notaroomba/cyberboard/README.md

<h1 align="center">
  <br>
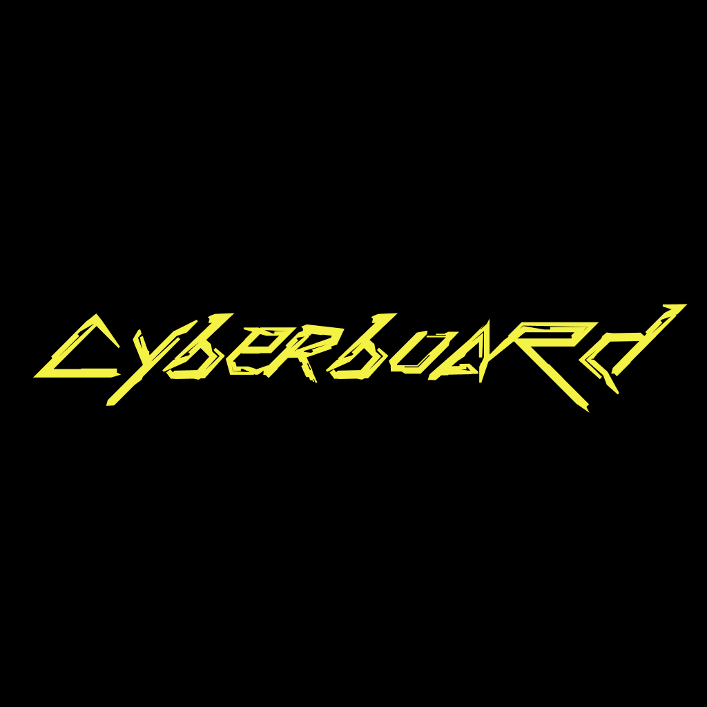
[picture p1: assets/logo.png]
Cyberboard V2
  
  <br>
  Cyberboard V2
  <br>
</h1>

<h4 align="center">
A Raspberry Pi Pico-sized STM32 development board with Bluetooth, battery support, IMU and a barometer!
</h4>

<div align="center">




</div>

<p align="center">
  <a href="#key-features">Key Features</a> •
  <a href="#pcb">PCB</a> •
  <a href="#credits">Credits</a> •
  <a href="#license">License</a>
</p>

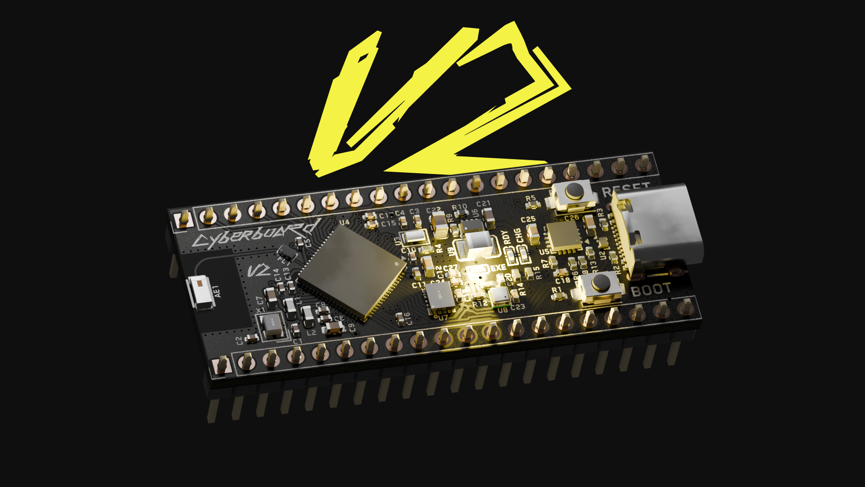
[picture p2: assets/Banner.png]
Cyberboard Banner


> **⚠️ Looking for V1?** The first version of the Cyberboard is available in the [v1 branch](https://github.com/notaroomba/cyberboard/tree/v1), but be warned: it doesn't work. V2 is a complete redesign with proper functionality.

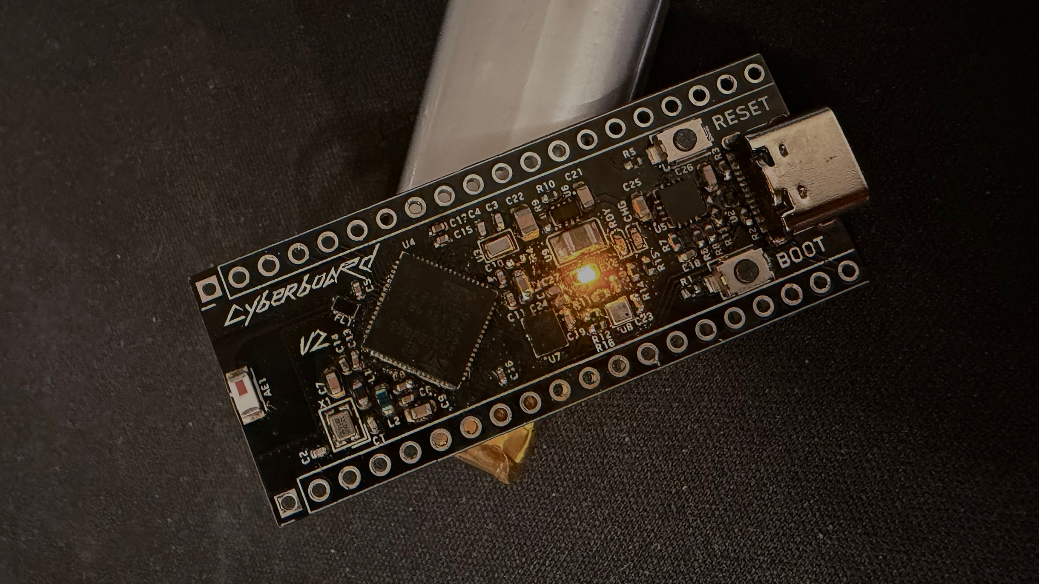
[picture p3: assets/final.png]


## Key Features

- **STM32WB55CG** microcontroller with Bluetooth support
- **Raspberry Pi Pico form factor** for compatibility
- **IMU and Barometer** - ICM-42688 (6-axis) and BMP580 pressure sensor for environmental/motion sensing
- **Battery charging** with BQ24072RGTR IC and solder pad for 1S LiPo
- **Buck-Boost converter** (TPS631000) for efficient power management
- **Multiple Status LEDs** for visual feedback
- **USB-C** connectivity
- **Ceramic Bluetooth antenna** with impedance matching
- **SWD test points** on the bottom for easy programming
- **4-layer PCB** design with optimized RF layout and routing
- **Panelized design** for cost-effective manufacturing

## PCB

Designed in KiCad with attention to RF design, power management, and sensor integration. The board features a 4-layer stackup (SIG/GND/PWR/SIG) with optimized routing for the Bluetooth antenna and sensitive analog signals.

### Schematic

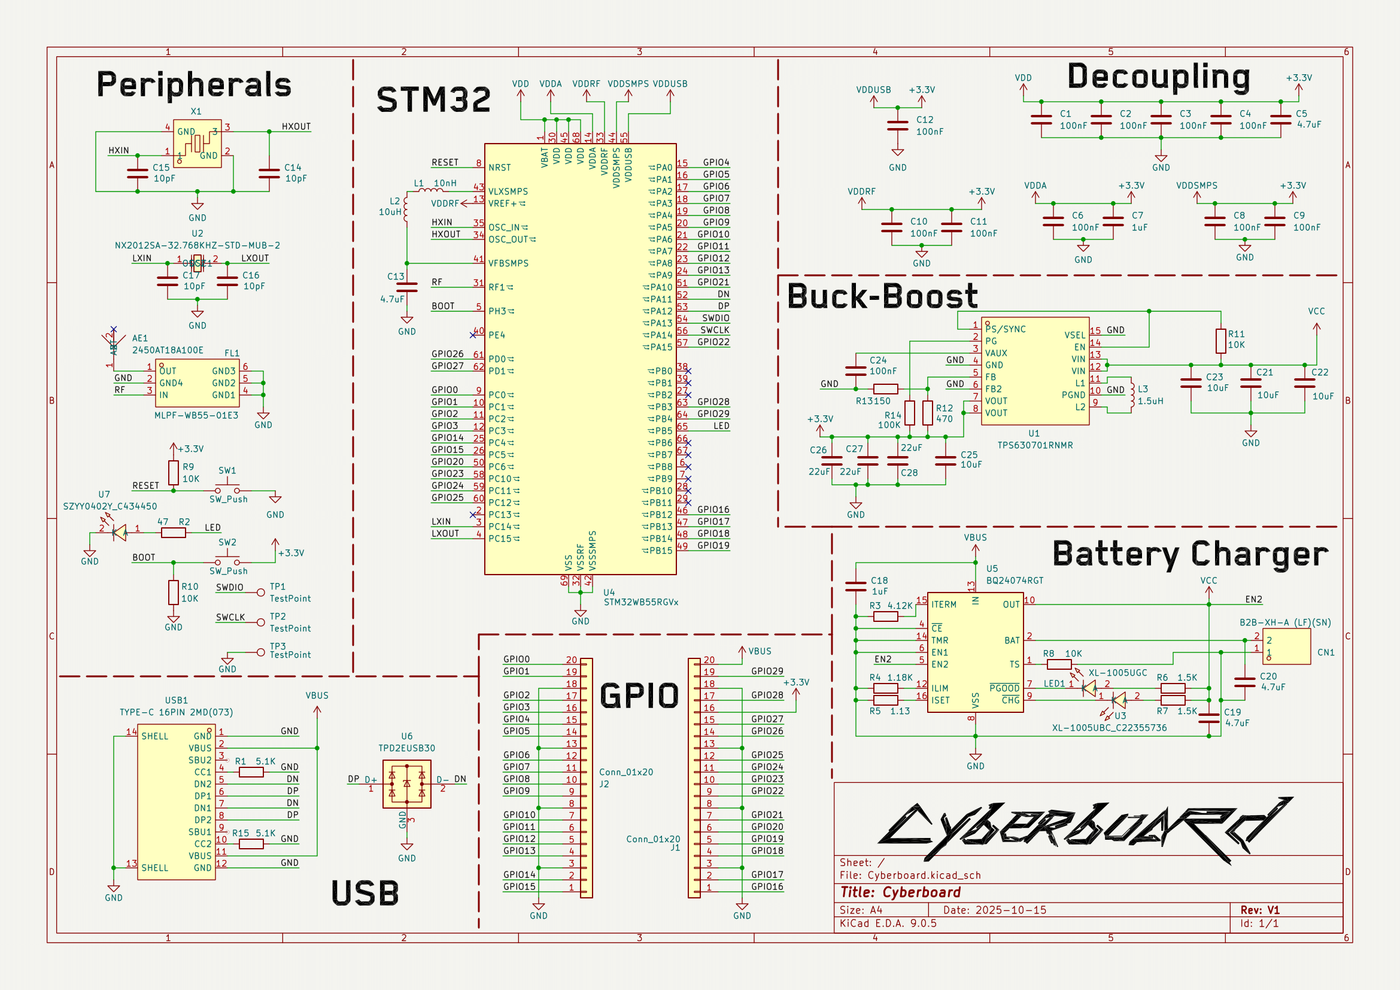
[picture p4: assets/schematic.png]
Schematic


### PCB Layers

The 4-layer stackup (SIG/GND/PWR/SIG) provides optimal signal integrity and power distribution:

**Layer 1 (Signal):**

PCB Layer 1

**Layer 2 (Ground):**

PCB Layer 2

**Layer 3 (Power):**

PCB Layer 3

**Layer 4 (Signal):**

PCB Layer 4

**Front:**

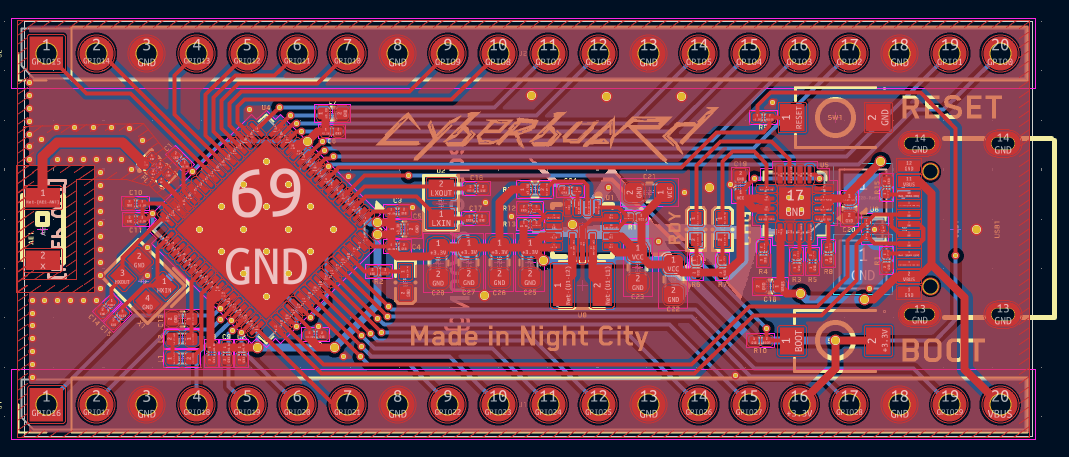
[picture p5: assets/pcb_front.png]
PCB Front


**Back:**

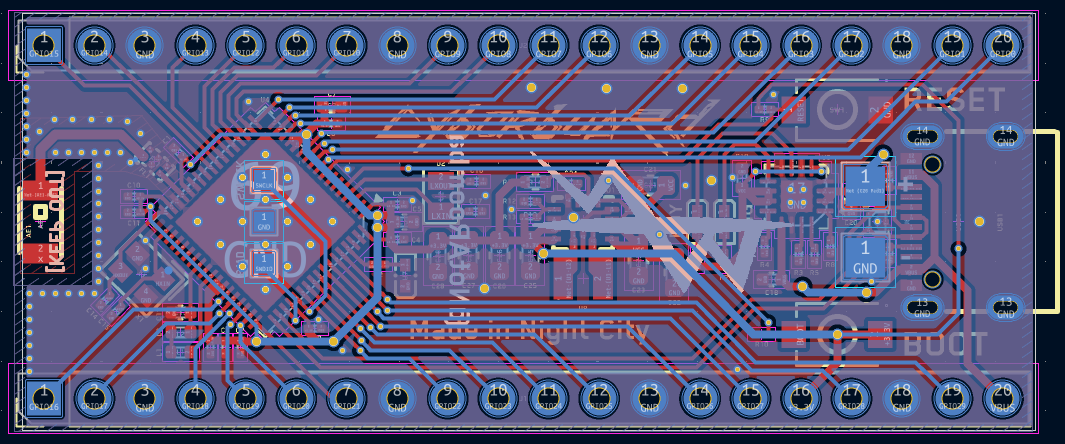
[picture p6: assets/pcb_back.png]
PCB Back


### JLCPCB Order

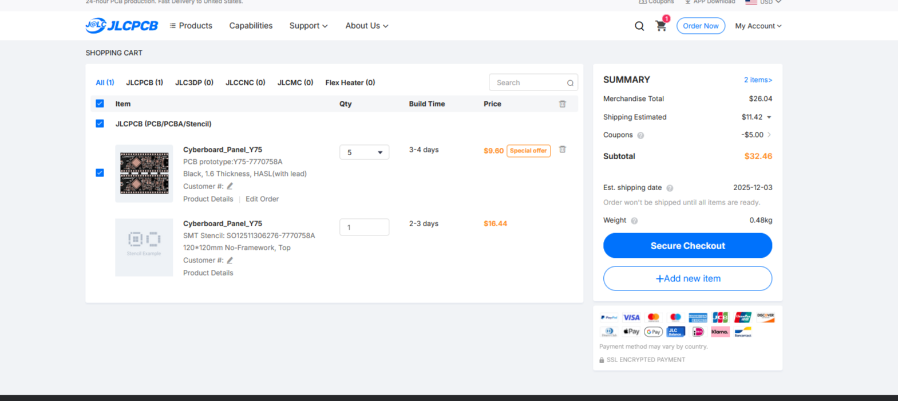
[picture p7: assets/jlcpcb.png]


## Credits

This project uses:

- [KiCad](https://www.kicad.org/)
- [Blender](https://www.blender.org/) for 3D renders
- [Hack Club Blueprint](https://blueprint.hackclub.com/projects/491)

## You may also like...

- [CyberCard](https://github.com/NotARoomba/CyberCard) – A Cyberpunk themed NFC hacker card
- [Ember](https://github.com/NotARoomba/ember) – USB-C PD Powered Hotplate
- [Trace](https://github.com/NotARoomba/trace) – An ruler for engineers
- [Athena](https://github.com/NotARoomba/athena) – A flight controlelr with a triple MCU architecture

## License

MIT

---

> [notaroomba.dev](https://notaroomba.dev) &nbsp;&middot;&nbsp;
> GitHub [@NotARoomba](https://github.com/NotARoomba) &nbsp;&middot;&nbsp;
