notaroomba/cyberboard/assets/final_rotated.png

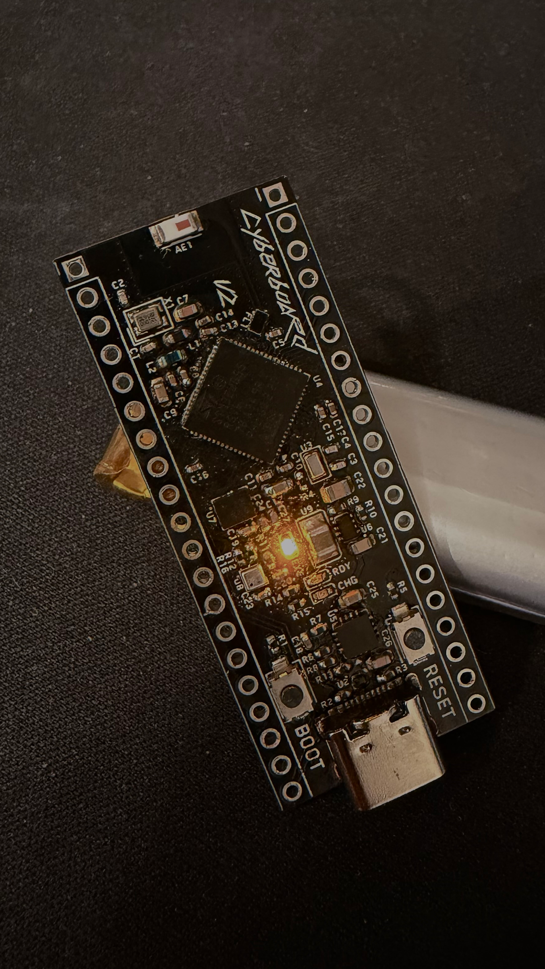
assets/final_rotated.png
