notaroomba/cyberboard/assets/jlcpcb_2.png

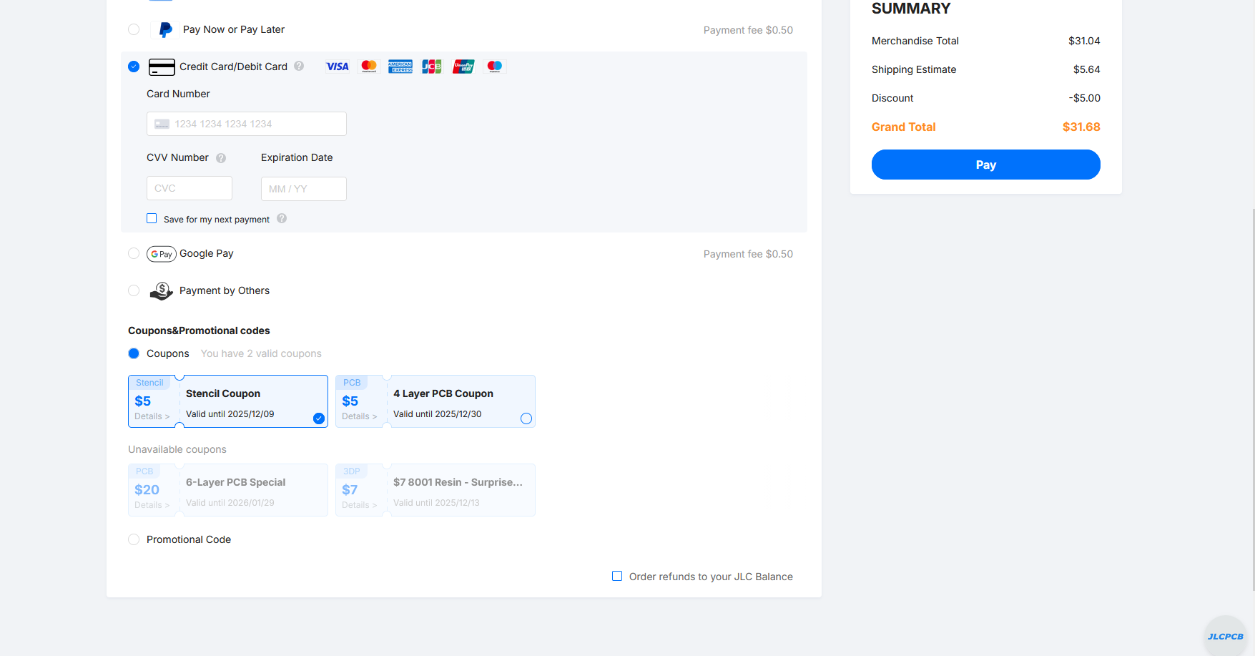
assets/jlcpcb_2.png
