notaroomba/cyberboard/assets/page.png

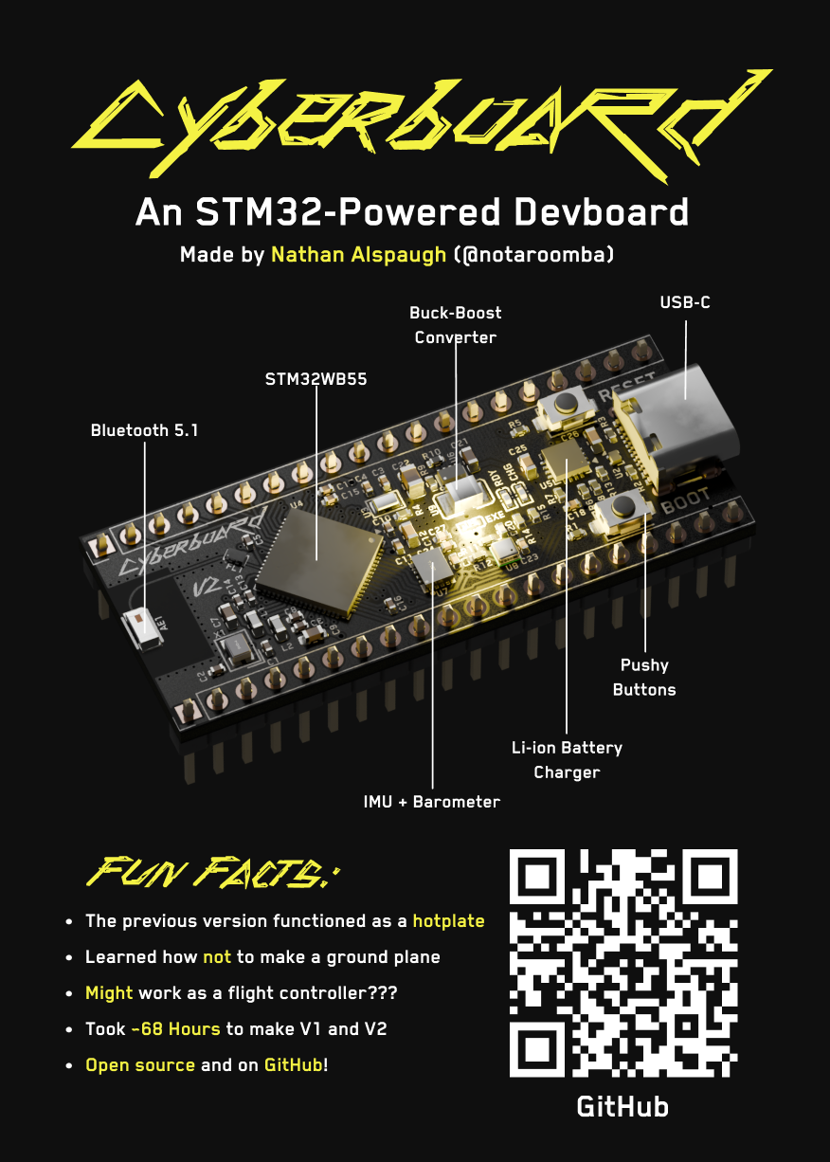
assets/page.png
