notaroomba/cyberboard/assets/Poster.png

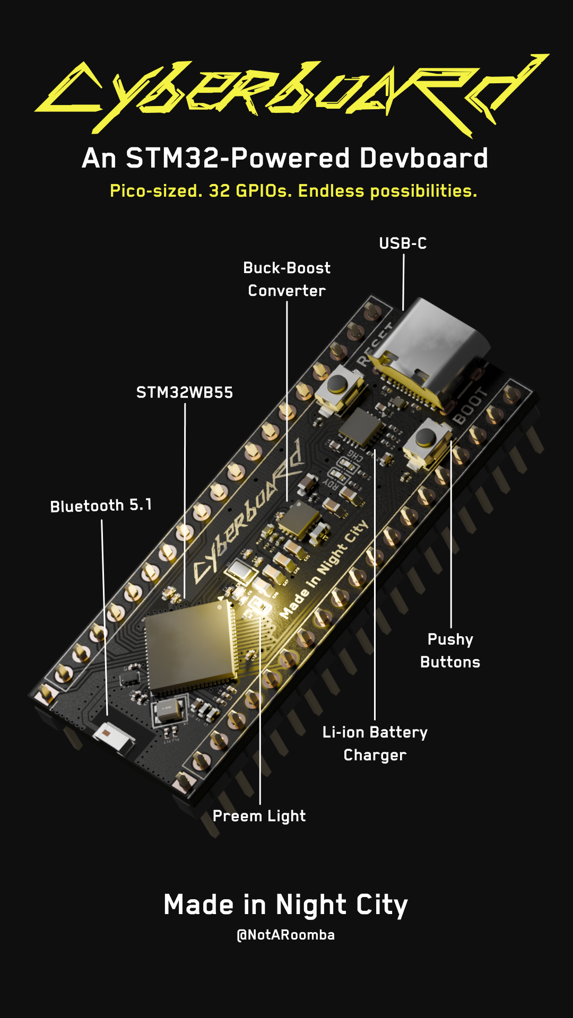
assets/Poster.png
