notaroomba/cyberboard/BOM.csv

Item | Cost | Source
PCB | 129.73 | JLCPCB
