notaroomba/cyberboard/docs/Cyberboard.step

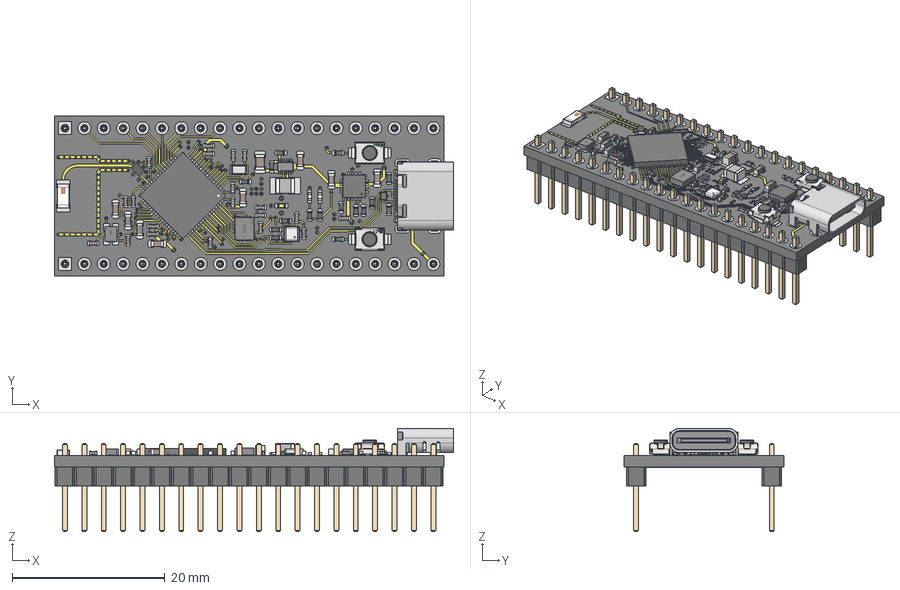
[picture p14: CAD file, 2026-03-08]
docs/Cyberboard.step
52.3 x 21.0 x 13.5 mm
SOT-583-8_L2.1-W1.2-P0.50-LS1.6-BL
C_0402_1005Metric x 20
R_0402_1005Metric x 16
C_0603_1608Metric x 6
LED0402_L1.0-W0.5-H0.2 x 2
WQFN-16-1EP_3x3mm_P0.5mm_EP1.6x1.6mm
QFN-68-1EP_8x8mm_P0.4mm_EP5.2x5.2mm
ANT-SMD_L3.2-W1.6-H1.3
L_0603_1608Metric x 2
PinHeader_1x20_P2.54mm_Vertical x 2
LGA-10_L2.0-W2.0-P0.50-TL_BMP580
CRYSTAL-SMD_L2.0-W1.2
LGA-14_L2.5-W3.0-H0.9-P0.50
L1008
C_0805_2012Metric
LED0402-FD_YELLOW
SW-SMD_L3.9-W2.9-H2.0-LS4.8 x 2
OSC-SMD_4P-L2.0-W1.6-H0.8
Texas_DRT-3
USB-C-SMD_TYPE-C-6PIN-2MD-073
FILTER-SMD_6P-L1.6-W1.0-P0.50-BL
Cyberboard_copper
Cyberboard_pad
Cyberboard_via
Cyberboard_PCB
