notaroomba/cyberboard/(list of files, cad)

Other CAD files:
blender/Cyberboard.blend
