notaroomba/cyberboard/JOURNAL.md

<!--
  Exported from Hack Club Blueprint on 2026-09-27.
  Source: https://blueprint.hackclub.com/projects/2195
  V1 source: https://blueprint.hackclub.com/projects/491
-->

# Cyberboard V1

## 10/13/2025 - Chip Selection and Schematic Start  

_Time spent: 5.0h_  

First I'm starting to define the functionality of the board. I want it to be the size of a Raspberry Pi Pico, and I want it to have Bluetooth support as well as headers for the STM32. I also want a JST connector to charge a 1S LiPo Battery for portability so I need a battery charging IC.

Chip Selection:

- STM32WB55CG
- TPS630701RNMR (Buck-Boost Converter)
- BQ24074 (Battery Charger)

Extras:

- SPI LEDs
- USB LEDs
- Battery JST Connector
- USB-C
- Ceramic Bluetooth Antenna



## 10/15/2025 1 AM - Finish Schematic and PCB Routing  

_Time spent: 9.0h_  

I started looking through all of the datasheets of all of the parts that I used to get the reference designs for each of the chips and then started wiring up each component.

I then ended up with this:


I still have to wire out the headers but I'm planning on doing that last after I have all the passive components in place.



## 10/15/2025 11 PM - Layout and Finish Board  

_Time spent: 12.0h_  

I decided to finish the layout and during, I wanted to add an LED and also the debugging pins as test points on the bottom of the board.



I then started routing all of the GPIO's first, then the clocks and then the power stuff. I used .2mm traces for everything that wasn't power and .4mm traces for power.



I also had to impedance match the antenna so basing it off this datasheet:


I then added the traces and also put stitching vias on the side. I also added the keepout zone and made sure that the ground plane on either side had the right clearance.



After that I finished adding the ground pours and ran DRC to fix the remaining errors and finally got this.



After finishing the board I decided to do some renders in Blender and here are the photos.





## 10/16/2025 - Resized Keep-out zone  

_Time spent: 0.8h_  

I decided to resize the keep-out zone after some advice from my informatics teacher and looking online at the datasheet. It originally says to have a 6.5mm space but I don't have that much space horizontally as I do vertically so the most I could do was 4.3mm.

Before: 

WhatsApp Image 2025-10-15 at 16.54.22_8be48b74.jpg

After:



## 10/17/2025 - Rerouted PCB on single side to save costs  

_Time spent: 6.0h_  



I had to reroute everything as the board was too expensive for double sided PCBA. So I decided to reduce the sizes down to 0201 for some components like the decoupling capacitors to try and save space and it worked. I then had enough space to move the battery charging IC to the other layer and I had to remove the JST connector and replaced it with 2 exposed pads on the bottom.




  

## 11/15/2025 - Tried fixing the PCB  

_Time spent: 14.0h_  

After receiving my board I rushed to plug it in but then it wouldn't connect and turned super hot. Later that day I sent it in the KiCad discord and turns out that everything was supposedly fine. A few days later after letting my intrusive thoughts win and letting the board heat up, I revised the schematics again and noticed there's a few errors. First of all I believe that I messed up the ground plane and literally encased the STM32 in 3V3 ring:



Then there's the other error of me not using the right decoupling capacitor values which should be 4.7uF.



Finally another error that completely hinders me from fixing the board is that those components are 0201 and are small and also expensive to manufacture (sorry I've learned my lesson)

WhatsApp Image 2025-11-15 at 00.44.59_852fff6f

I spent the entire day trying to learn how to solder 0201 as I was trying to see if I could connect a capacitor that I took from an old wifi router to the board. I tried doing this by soldering a thin copper wire (taken from a jumper cable) to the end of a capacitor and then that capacitor to ground:

WhatsApp Image 2025-11-15 at 00.44.59_0f044e43

WhatsApp Image 2025-11-15 at 00.44.59_217dc7c0

Although my soldering iron kept burning the flux and I had to use nail polish remover to try and clean it because I don't have isopropyl alcohol.

WhatsApp Image 2025-11-15 at 01.02.20_5e53268a

After talking with @Kai Pereira, I realized that I had a lot to improve in terms of cost and component selection and that's my goal for V2, to make it as cheap as possible < 50 USD, and maybe include more features.

All this I plan to do after I finish my heatplate as I want to be able to solder everything by hand.

## 12/1/2025 - Banner Image  

_Time spent: 0.1h_  

Finally fixed the bug so heres a temp journal to add in the banner so that it looks cool on the blueprint website aaaaaaaaaaaaaaaaaaaaaaaaaaaaaaaaaaaaaaaaaaaaa

Banner

# Cyberboard V2

## 11/28/2025 - Fixed Schematic and Add Sensors  

_Time spent: 6.0h_  

So after the first iteration of the Cyberboard, there were a lot of issues, mainly me being stupid and not using the right values but also in the design of the PCB (not using 4 layers) so in this version I am going to fix that and upgrade it by adding an IMU/Barometer to make it the ultimate devboard for small projects!

Ah and I also plan on hand soldering it / reflow it using my custom hotplate (lol making tools to make tools) so it will be way cheaper and make up for my past mistakes.

I will be adding on the ICM-42688 and BMP580 and also I was thinking about reducing the size of the buck-boost converter as it was one of the biggest contributors to price/complexity on the board. So like any good engineer, I went on LCSC and searched for the most used DC DC converter to implement and found TPS631000 and it's perfect looking at the application implementation:



I think with this I can rewire the board completely and add in more functionality. So I thought about what other cool functionality and I decided on adding in a current sensor for the battery

 

I also found a cheaper battery charging IC: BQ24072RGTR instead of the BQ24074RGT

The only thing they have differently is one pin that instead of ITERM it's TD:



AND IT'S WAY CHEAPER AND COSTS ONLY 0.8 USD INSTEAD OF 3 USD

AND IT's LITERALLY A DROP IN REPLACEMENT FOR THAT CHIP:



I just had to change the value for TD to a more standarized value but it should work the same as a pull down resistor:


Reading through the datasheet I also saw that the example application was using a custom timer and to reduce cost even more I decided to use the default timer as that will suffice.



After I got the battery fixed I went on and fixed the decoupling capacitors for the STM32:



After that I imported the new buck converter and looked at the datasheet:



I had to import this inductor `DFE252012P-1R0M=P2` as it was specified in the datasheet:



After setting up the rest of the pins, I came up with this: 



Now it's time to set up the sensors that I'll be using (ICM-42688-PC and BMP580):



Thankfully I have enough pins free on my devboard, and you can't say that a devboard is a devboard if you aren't using all of the pins lol.



but before deciding on which communication interface I'm going to use, I'll have to edit the pins on STM32CubeMX:



I originally had some EVENTOUT pins that labeled which pins weren't going to be used but this time, I am going to try and use all of them. In total I have 11 pins free to play around with, I plan on using LED's with the extra pins to at least have 3 status ones.  

## 11/30/2025 12:04 AM - PCB Layout and Routing  

_Time spent: 5.0h_  

I started the layout of the PCB and noticed a few errors in my schematic and fixed them (I2C lines strike again) and then had something like this:



I found out that I can compact the board alot and make room for the antenna as I plan to use the bottom layer mainly for the GPIO's as the top layer is kind of busy with all of the passive components.

I organized it a bit more and got this layout, but I wasn't satisfied with the way that there was a squareish hole off center so I redid it again


(before)


(after)

And after that I didn't liked how it looked so I went back to the original and planned on putting a V2 in the squareish hole.

I then started routing up the design and also making minor changes here and there to not cover some silkscreen, I also enjoyed routing this section as I find that it looks cool the stripe effect:



## 11/30/2025 12:27 AM - Pin Selection (BEFORE PREVIOUS JOURNAL)  

_Time spent: 4.0h_  

I started selecting the pins on STM3CubeMX and wanted to use I2C for the BMP580 and then SPI for the IMU. Another design requirement is that I wanted it as far away from the Bluetooth antenna as possible, which is why I decided on this pinout:



I might interchange the CS and interrupt pins as to better route it later but that's a good starting point. I then finished wiring the ICM:



AND I REMEMBERED TO ADD PULL UP RESISTORS TO THE I2C LINES



then I had to organize the schematic a bit as there wasn't any space for the new sensors lol



I then edited the footprints and made sure that all of them were at least 0402 (ptsd soldering 0201).

I forgot that I had this draft saved on one laptop so when I used another I pushed a journal from there and I forgot about these changes so aja, this journal comes before `PCB Layout and Routing`  

## 11/30/2025 2 AM - Finished Routing and Antenna  

_Time spent: 2.0h_  

I spent a bit of time finishing up the routing and also making sure that everything looks neat including the silkscreen:



I somehow did it and managed to fit an IMU and Barometer in such a tiny 1 SIDED BOARD

I had fun routing the antenna as I had a crisis and thought I had my antenna for Ember wrong but I just recalculated the impedance badly



It's a 4 layer board so SIG/GND/PWR/SIG and I had some stitching vias for 3v3:



Aside from that I just finished routing and tmrw I'll start work on the renders and also getting feedback from the KiCad Discord.

## 11/30/2025 1 PM - Blender Render, Panelization, and LCSC  

_Time spent: 4.0h_  

After fixing some pins that were out of order due to routing, I started rendering the PCB in Blender based on the last file. 

Banner



It looks a bit drab so I am going to add in more lights like in Trace and see if that helps out a bit.

Meanwhile, I decided to panelize the PCB because in V1, there was a lot of extra space that I could use to make more copies and not have to pay extra.



After that I also exported the BOM and went to LCSC to check out how much it cost and it was surprisingly cheap at (taking advantage of the MOQ for most).

I also had to specify the stackup (which I kinda forgot to do for Ember but I sent an email requesting to change it). This also meant that I had to change the width of the traces and also the width of the board.

## 3/7/2026 - IT WORKS!!!  

_Time spent: 39.0h_  

ookay so its been a while since I've worked on this since getting a gap year so I finally finished it and it works!

basically I had all of the components and saw the stencil and it was a bit hard to get right



and then decided to try and hotplate it with Ember in a hotel lobby (actually)



and it worked kinda! although at first it turned on but didn't connect to my laptop so I was wondering why that was, but I hadn't had time to debug it until I stopped moving around.



it was then until I finally got to HQ and found a lovely soldering station but I kinda wanted to make more PCB's to try and test them so I did a thing in my room and reflowed another one:



but it faced the same problem that the usb wouldnt enumerate so I figured that it was a problem with the STM32

I wouldn't give up tho so I went to HQ and found that they had a wonderful hot air machine and hot plate so I tried reflowing the STM32 again to try and fix it



but after a few tries of soldering it on and off it still hadn't worked but it was then that it started connecting to my PC but when I tried making a test program for the yellow light it wouldn't turn it on, and I tested with a multimeter and it should have worked but then i took a look at the side and apparently the stm wasn't totally connected so I had to retry again until it worked



now I could connect to it but I still had a few problems with the barometer so I tried to resolder it and actually had to cut a trace because it wasn't supposed to be connected to ground (CSB)





and that worked because initially it wasnt detecting any chips on the i2c line that the bmp580 was on so yea...

after I got that working it was time for the IMU and heres where it got crazy, so I first got some drivers for it and tried to connect to the IMU and get its WHOAMI register but it kept giving me 0x00 (nothing) so that was kinda suspicious so then I reflowed it varios times until I noticed that it might be a different imu because the chip symbols were different and IT WAS!

looking through the LCSC part number on the package it was different from the one that I had originally wanted

 



in any case I still fixed and started up a demo that showcased all of the features of the board!
