notaroomba/cyberboard/hardware/Cyberboard.kicad_pcb

## KiCad design hardware/Cyberboard.kicad_pcb (2026-10-11)

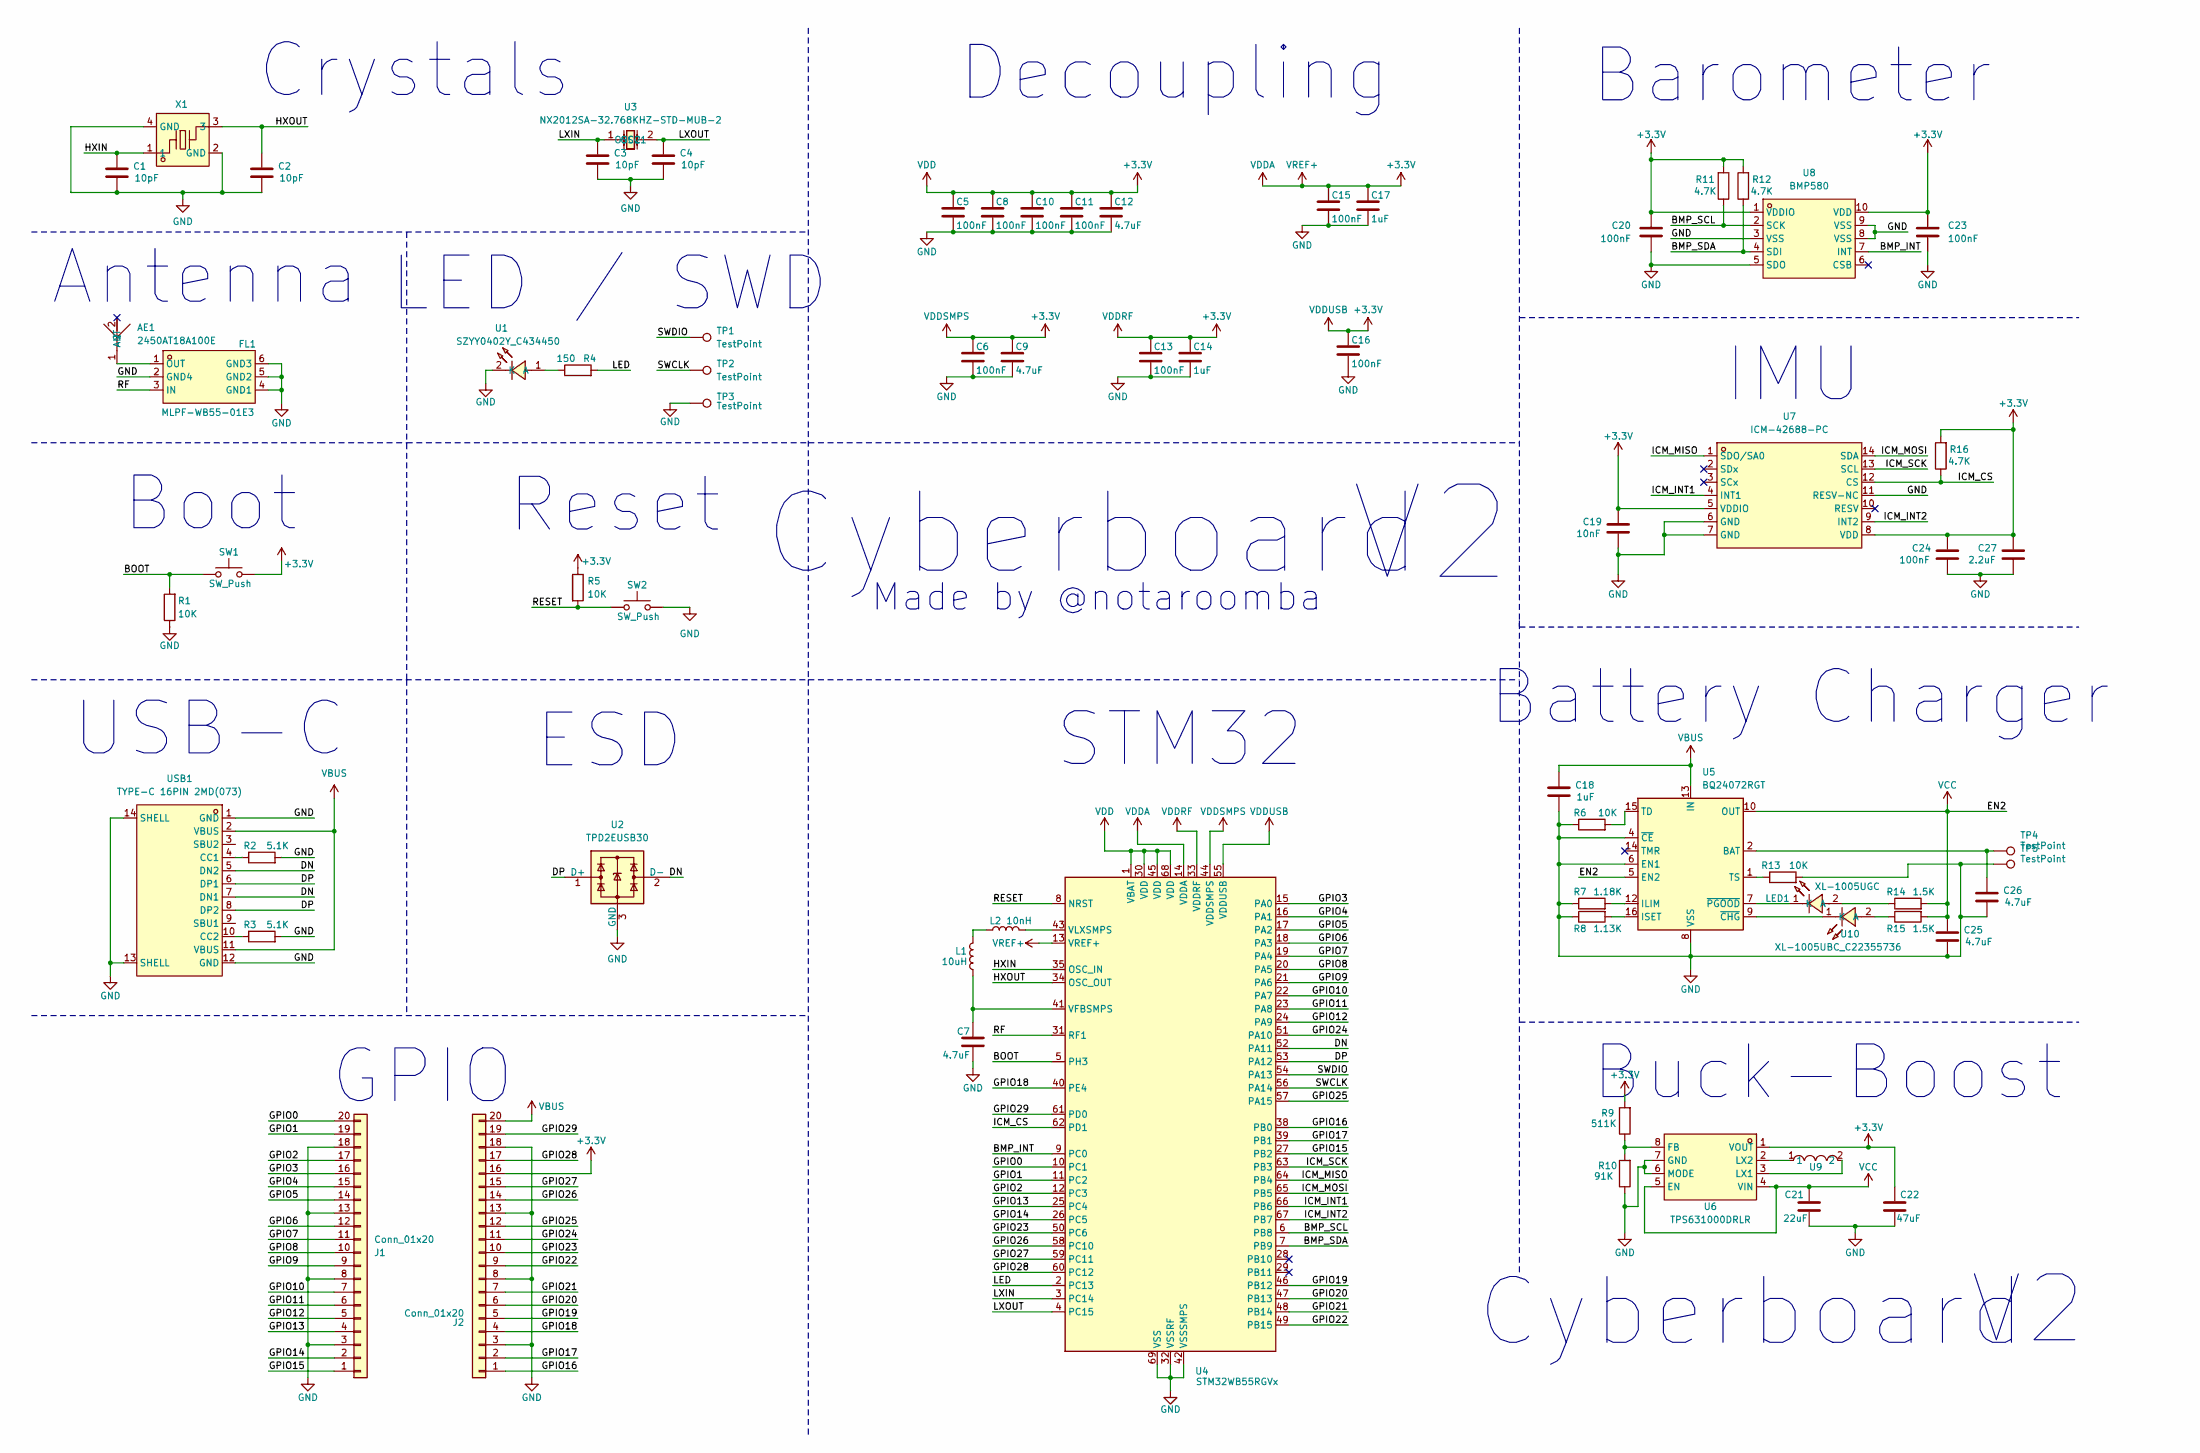
[picture p15: schematic Cyberboard.kicad_sch]

Parts:
AE1: 2450AT18A100E; ANT-SMD_L3.2-W1.6; LCSC Part C89334
C1, C2, C3, C4: 10pF; C_0402_1005Metric
C5, C6, C8, C10, C11, C13, C15, C16, C20, C23, C24: 100nF; C_0402_1005Metric
C7, C9, C12, C25, C26: 4.7uF; C_0603_1608Metric
C14, C17, C18: 1uF; C_0402_1005Metric
C19: 10nF; C_0402_1005Metric
C21: 22uF; C_0603_1608Metric; LCSC C361061
C22: 47uF; C_0805_2012Metric; LCSC C471380
C27: 2.2uF; C_0402_1005Metric
FL1: MLPF-WB55-01E3; FILTER-SMD_6P-L1.6-W1.0-P0.50-BL; LCSC Part C2651048
J1, J2: Conn_01x20; PinHeader_1x20_P2.54mm_Vertical; LCSC C42431804
L1: 10uH; L_0603_1608Metric
L2: 10nH; L_0603_1608Metric
LED1: XL-1005UGC; LED0402-RD_GREEN; LCSC Part C965793
R1, R5, R6, R13: 10K; R_0402_1005Metric
R2, R3: 5.1K; R_0402_1005Metric
R4: 150; R_0402_1005Metric; LCSC C25082
R7: 1.18K; R_0402_1005Metric
R8: 1.13K; R_0402_1005Metric
R9: 511K; R_0402_1005Metric
R10: 91K; R_0402_1005Metric
R11, R12, R16: 4.7K; R_0402_1005Metric
R14, R15: 1.5K; R_0402_1005Metric
SW1, SW2: SW_Push; SW-SMD_L3.9-W3.0-P4.45; LCSC C720477
TP1, TP2, TP3: TestPoint; TestPoint_Pad_1.0x1.0mm
TP4, TP5: TestPoint; TestPoint_Pad_2.0x2.0mm
U1: SZYY0402Y_C434450; LED0402-FD_YELLOW; LCSC Part C434450
U2: TPD2EUSB30; Texas_DRT-3
U3: NX2012SA-32.768KHZ-STD-MUB-2; CRYSTAL-SMD_L2.0-W1.2; LCSC Part C891748
U4: STM32WB55RGVx; QFN-68-1EP_8x8mm_P0.4mm_EP6.4x6.4mm; LCSC C401505
U5: BQ24072RGT; VQFN-16-1EP_3x3mm_P0.5mm_EP1.6x1.6mm; LCSC C140288
U6: TPS631000DRLR; SOT-583-8_L2.1-W1.2-P0.50-LS1.6-BL; LCSC Part C5219190
U7: ICM-42688-PC; LGA-14_L3.0-W2.5-P0.50-TL; LCSC Part C48586483
U8: BMP580; LGA-10_L2.0-W2.0-P0.50-TL_BMP580; LCSC Part C22391138
U9: DFE252012P-1R0M=P2; L1008; LCSC Part C882955
U10: XL-1005UBC_C22355736; LED0402-RD; LCSC Part C22355736
USB1: TYPE-C 16PIN 2MD(073); USB-C-SMD_TYPE-C-6PIN-2MD-073; LCSC Part C2765186
X1: NX2016SA-32MHZ-STD-CZS-5; OSC-SMD_4P-L2.0-W1.6-BL; LCSC Part C843260

Connections:
+3.3V: C5.1, C6.1, C8.1, C9.1, C10.1, C11.1, C12.1, C13.1, C14.1, C15.1, C16.1, C17.1, C19.1, C20.1, C22.1, C23.1, C24.1, C27.1, J2.16, R5.1, R9.2, R11.2, R12.2, R16.2, SW1.2, U4.1 (VBAT), U4.13 (VREF+), U4.14 (VDDA), U4.30 (VDD), U4.33 (VDDRF), U4.44 (VDDSMPS), U4.45 (VDD), U4.55 (VDDUSB), U4.68 (VDD), U6.1 (VOUT), U7.5 (VDDIO), U7.8 (VDD), U8.1 (VDDIO), U8.10 (VDD)
/BMP_INT: U4.9 (PC0), U8.7 (INT)
/BMP_SCL: R11.1, U4.6 (PB8), U8.2 (SCK)
/BMP_SDA: R12.1, U4.7 (PB9), U8.4 (SDI)
/BOOT: R1.2, SW1.1, U4.5 (PH3)
/DN: U2.2 (D-), U4.52 (PA11), USB1.5 (DN2), USB1.7 (DN1)
/DP: U2.1 (D+), U4.53 (PA12), USB1.6 (DP1), USB1.8 (DP2)
/GPIO0: J1.20, U4.10 (PC1)
/GPIO1: J1.19, U4.11 (PC2)
/GPIO2: J1.17, U4.12 (PC3)
/GPIO3: J1.16, U4.15 (PA0)
/GPIO4: J1.15, U4.16 (PA1)
/GPIO5: J1.14, U4.17 (PA2)
/GPIO6: J1.12, U4.18 (PA3)
/GPIO7: J1.11, U4.19 (PA4)
/GPIO8: J1.10, U4.20 (PA5)
/GPIO9: J1.9, U4.21 (PA6)
/GPIO10: J1.7, U4.22 (PA7)
/GPIO11: J1.6, U4.23 (PA8)
/GPIO12: J1.5, U4.24 (PA9)
/GPIO13: J1.4, U4.25 (PC4)
/GPIO14: J1.2, U4.26 (PC5)
/GPIO15: J1.1, U4.27 (PB2)
/GPIO16: J2.1, U4.38 (PB0)
/GPIO17: J2.2, U4.39 (PB1)
/GPIO18: J2.4, U4.40 (PE4)
/GPIO19: J2.5, U4.46 (PB12)
/GPIO20: J2.6, U4.47 (PB13)
/GPIO21: J2.7, U4.48 (PB14)
/GPIO22: J2.9, U4.49 (PB15)
/GPIO23: J2.10, U4.50 (PC6)
/GPIO24: J2.11, U4.51 (PA10)
/GPIO25: J2.12, U4.57 (PA15)
/GPIO26: J2.14, U4.58 (PC10)
/GPIO27: J2.15, U4.59 (PC11)
/GPIO28: J2.17, U4.60 (PC12)
/GPIO29: J2.19, U4.61 (PD0)
/HXIN: C1.1, U4.35 (OSC_IN), X1.1
/HXOUT: C2.1, U4.34 (OSC_OUT), X1.3
/ICM_CS: R16.1, U4.62 (PD1), U7.12 (CS)
/ICM_INT1: U4.66 (PB6), U7.4 (INT1)
/ICM_INT2: U4.67 (PB7), U7.9 (INT2)
/ICM_MISO: U4.64 (PB4), U7.1 (SDO/SA0)
/ICM_MOSI: U4.65 (PB5), U7.14 (SDA)
/ICM_SCK: U4.63 (PB3), U7.13 (SCL)
/LED: R4.2, U4.2 (PC13)
/LXIN: C3.1, U3.1 (OSC1), U4.3 (PC14)
/LXOUT: C4.1, U3.2 (OSC2), U4.4 (PC15)
/RESET: R5.2, SW2.1, U4.8 (NRST)
/RF: FL1.3 (IN), U4.31 (RF1)
/SWCLK: TP2.1, U4.56 (PA14)
/SWDIO: TP1.1, U4.54 (PA13)
GND: C1.2, C2.2, C3.2, C4.2, C5.2, C6.2, C7.2, C8.2, C9.2, C10.2, C11.2, C12.2, C13.2, C14.2, C15.2, C16.2, C17.2, C18.2, C19.2, C20.2, C21.2, C22.2, C23.2, C24.2, C25.2, C26.2, C27.2, FL1.2 (GND4), FL1.4 (GND1), FL1.5 (GND2), FL1.6 (GND3), J1.3, J1.8, J1.13, J1.18, J2.3, J2.8, J2.13, J2.18, R1.1, R2.2, R3.2, R6.1, R7.1, R8.1, R10.1, R13.2, SW2.2, TP3.1, TP5.1, U1.2 (K), U2.3 (GND), U4.32 (VSSRF), U4.42 (VSSSMPS), U4.69 (VSS), U5.4 (~CE), U5.6 (EN1), U5.8 (VSS), U5.17 (VSS), U6.6 (MODE), U6.7 (GND), U7.6 (GND), U7.7 (GND), U7.11 (RESV-NC), U8.3 (VSS), U8.5 (SDO), U8.8 (VSS), U8.9 (VSS), USB1.1 (GND), USB1.12 (GND), USB1.13 (SHELL), USB1.14 (SHELL), X1.2 (GND), X1.4 (GND)
unnamed: AE1.1 (ANT), FL1.1 (OUT)
unnamed: C26.1, TP4.1, U5.2 (BAT), U5.3 (BAT)
unnamed: L1.1, L2.2
unnamed: LED1.2 (A), R14.1
unnamed: LED1.1 (K), U5.7 (~PGOOD)
unnamed: R4.1, U1.1 (A)
unnamed: C7.1, L1.2, U4.41 (VFBSMPS)
unnamed: L2.1, U4.43 (VLXSMPS)
unnamed: R7.2, U5.12 (ILIM)
unnamed: R8.2, U5.16 (ISET)
unnamed: R6.2, U5.15 (TD)
unnamed: R13.1, U5.1 (TS)
unnamed: R9.1, R10.2, U6.8 (FB)
unnamed: U6.3 (LX1), U9.2
unnamed: U6.2 (LX2), U9.1
unnamed: R15.1, U10.2 (A)
unnamed: U5.9 (~CHG), U10.1 (K)
unnamed: R2.1, USB1.4 (CC1)
unnamed: R3.1, USB1.10 (CC2)
VBUS: C18.1, J2.20, U5.13 (IN), USB1.2 (VBUS), USB1.11 (VBUS)
VCC: C21.1, C25.1, R14.2, R15.2, U5.5 (EN2), U5.10 (OUT), U5.11 (OUT), U6.4 (VIN), U6.5 (EN)

Notes on the sheet:
Cyberboard
Decoupling
IMU
Made by @notaroomba
Reset
LED / SWD
Antenna
STM32
ESD
Battery Charger
Boot
USB-C
Buck-Boost
Barometer
GPIO
Crystals

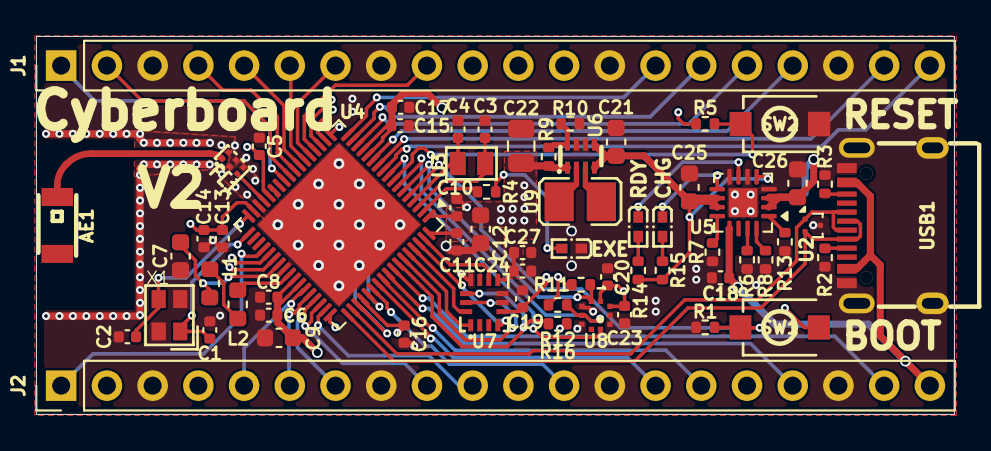
[picture p16: board Cyberboard.kicad_pcb from above]

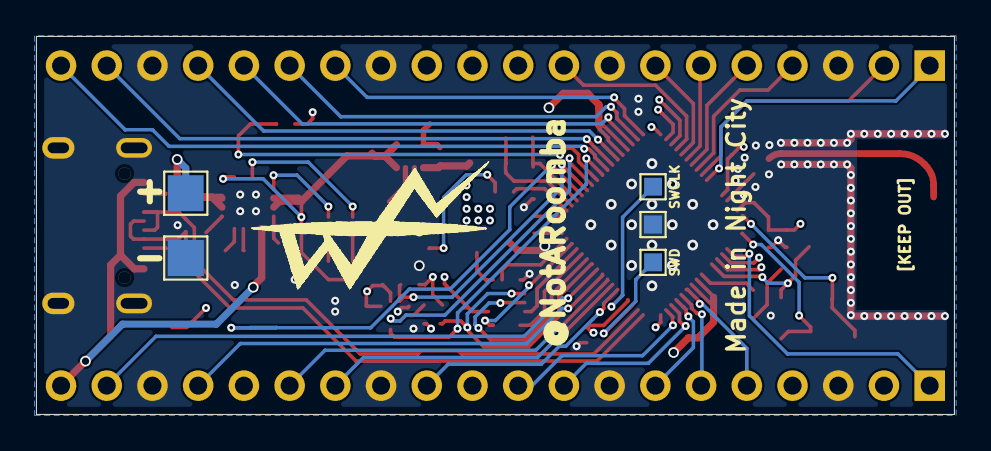
[picture p17: board Cyberboard.kicad_pcb from below]

Board: 4 copper layers, 51.0 x 21.0 mm, 69 parts (5 on the bottom side), 74 nets.
