notaroomba/cyberboard/software/firmware/software.ioc

Mcu.UserName=STM32WB55RGVx
PA11.Signal=USB_DM
PA12.Signal=USB_DP
PB3.GPIO_Label=ICM_SCK
PB3.Signal=SPI1_SCK
PB4.GPIO_Label=ICM_MISO
PB4.Signal=SPI1_MISO
PB5.GPIO_Label=ICM_MOSI
PB5.Signal=SPI1_MOSI
PB6.GPIO_Label=ICM_INT1
PB6.Signal=GPXTI6
PB7.GPIO_Label=ICM_INT2
PB7.Signal=GPXTI7
PB8.GPIO_Label=BMP_SCL
PB8.Signal=I2C1_SCL
PB9.GPIO_Label=BMP_SDA
PB9.Signal=I2C1_SDA
PC0.GPIO_Label=BMP_INT
PC0.Signal=GPXTI0
PC13.GPIO_Label=LED
PC13.Signal=GPIO_Output
PC14-OSC32_IN.Signal=RCC_OSC32_IN
PC15-OSC32_OUT.Signal=RCC_OSC32_OUT
PD1.GPIO_Label=ICM_CS
PD1.Signal=GPIO_Output
