notaroomba/cyberboard/software/firmware/Core/Src/stm32wbxx_it.c

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

/* Includes ------------------------------------------------------------------*/
#include "main.h"
#include "stm32wbxx_it.h"
/* USER CODE BEGIN Includes */
#include "app_common.h"
/* USER CODE END Includes */

/* External variables --------------------------------------------------------*/
extern PCD_HandleTypeDef hpcd_USB_FS;
/******************************************************************************/
/*           Cortex Processor Interruption and Exception Handlers          */
/******************************************************************************/
/**
  * @brief This function handles Non maskable interrupt.
  */
void NMI_Handler(void)
{
  /* USER CODE BEGIN NonMaskableInt_IRQn 1 */
   while (1)
  {
  }
  /* USER CODE END NonMaskableInt_IRQn 1 */
}

/**
  * @brief This function handles Hard fault interrupt.
  */
void HardFault_Handler(void)
{
  while (1)
  {
  }
}

/**
  * @brief This function handles Memory management fault.
  */
void MemManage_Handler(void)
{
  while (1)
  {
  }
}

/**
  * @brief This function handles Prefetch fault, memory access fault.
  */
void BusFault_Handler(void)
{
  while (1)
  {
  }
}

/**
  * @brief This function handles Undefined instruction or illegal state.
  */
void UsageFault_Handler(void)
{
  while (1)
  {
  }
}

/**
  * @brief This function handles System service call via SWI instruction.
  */
void SVC_Handler(void)
{
}

/**
  * @brief This function handles Debug monitor.
  */
void DebugMon_Handler(void)
{
}

/**
  * @brief This function handles Pendable request for system service.
  */
void PendSV_Handler(void)
{
}

/**
  * @brief This function handles System tick timer.
  */
void SysTick_Handler(void)
{
  HAL_IncTick();
}

/******************************************************************************/
/* STM32WBxx Peripheral Interrupt Handlers                                    */
/* Add here the Interrupt Handlers for the used peripherals.                  */
/* For the available peripheral interrupt handler names,                      */
/* please refer to the startup file (startup_stm32wbxx.s).                    */
/******************************************************************************/

/**
  * @brief This function handles USB low priority interrupt, USB wake-up interrupt through EXTI line 28.
  */
void USB_LP_IRQHandler(void)
{
  HAL_PCD_IRQHandler(&hpcd_USB_FS);
}

/**
  * @brief This function handles HSEM global interrupt.
  */
void HSEM_IRQHandler(void)
{
  HAL_HSEM_IRQHandler();
}

/* USER CODE BEGIN 1 */
/**
  * @brief This function handles IPCC RX occupied interrupt.
  */
volatile uint32_t ipcc_rx_count = 0;
void IPCC_C1_RX_IRQHandler(void)
{
  ipcc_rx_count++;
  HW_IPCC_Rx_Handler();
}

/**
  * @brief This function handles IPCC TX free interrupt.
  */
volatile uint32_t ipcc_tx_count = 0;
void IPCC_C1_TX_IRQHandler(void)
{
  ipcc_tx_count++;
  HW_IPCC_Tx_Handler();
}
/* USER CODE END 1 */
