notaroomba/cyberboard/(commit log)

2025-10-16 add readme and also blender files
    [Cyberboard.blend, Cyberboard.kicad_pcb, Cyberboard.kicad_sch]
2025-10-16 add order and prod files
    [BOM.csv, Cyberboard.kicad_pcb, Cyberboard.kicad_sch, bom.csv, designators.csv, positions.csv]
2025-10-16 resized keep out
    [Cyberboard.kicad_pcb]
2025-10-17 updated pcb for single side pcba
    [BOM.csv, Cyberboard.blend, Cyberboard.kicad_pcb, Cyberboard.kicad_sch, bom.csv, designators.csv, positions.csv]
2025-10-20 prod final
    [Cyberboard.kicad_pcb]
2025-10-21 forgot resistor values and change in inductor footprint
    [Cyberboard.kicad_pcb, Cyberboard.kicad_sch, bom.csv, designators.csv, positions.csv]
2025-12-11 Update battery charging description in README
2025-12-11 Remove features list from PCB section
    Removed features section from PCB description.
2025-12-11 Update README with PCB layer images
    Added images for PCB layers and front/back views.
2026-03-07 add imu
2026-03-08 it works!!
    [Cyberboard.kicad_pcb, Cyberboard.kicad_sch]
2026-03-08 better filtering
2026-03-08 move around firmware and create websocket server
    [Cyberboard.kicad_pcb, Cyberboard.step]
2026-03-08 add in build
    [Cyberboard.step]
2026-04-02 fix corrupted file
    [Cyberboard.kicad_pcb]
