notaroomba/cyberboard/(notices)

Notices in the files:
software/firmware/STM32_WPAN/App/tl_dbg_conf.h:
Copyright (c) 2026 STMicroelectronics.
All rights reserved.
This software is licensed under terms that can be found in the LICENSE file
