notaroomba/cyberboard/assets/Cyberboard.png

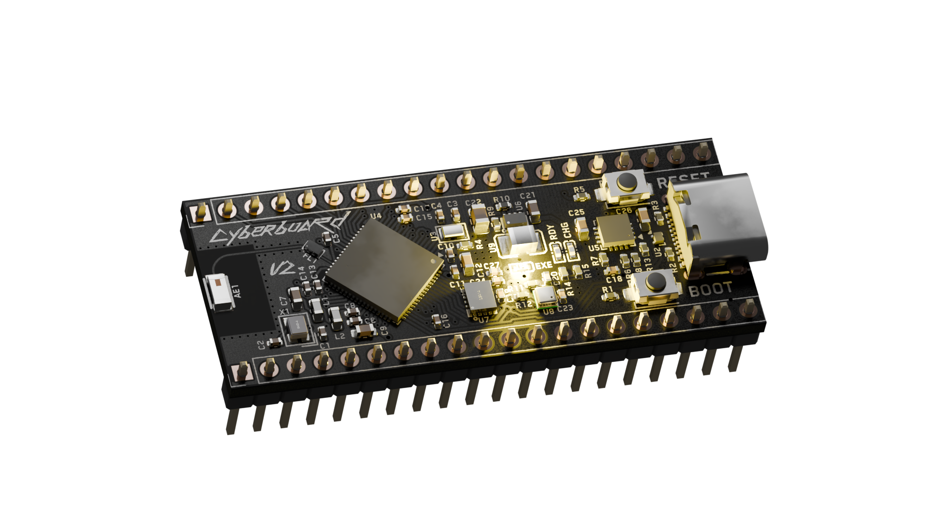
assets/Cyberboard.png
